bornity/deltesian-part-files/Deltesian - Gen 1/BOM/Deltesian - Gen1 BOM - Google Sheet Link.txt

Deltesian - Gen 1 BOM Google Sheet Link

NOTE: Work in Progress

https://goo.gl/rh56ii
