bornity/deltesian-part-files/Deltesian - Gen 2/Sub-Plate Plate V2.2 - Printed.stl

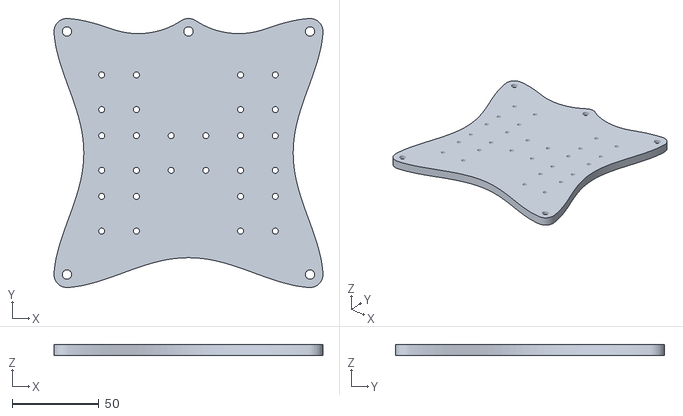
[picture p9: CAD file, 2018-10-27]
Deltesian - Gen 2/Sub-Plate Plate V2.2 - Printed.stl
155.0 x 155.0 x 6.50
