bornity/deltesian-part-files/Stage 1 - XZ Frame/v1.0.1 - XZ Frame/STL/Z_Axis Corner Bracket v1.0.stl

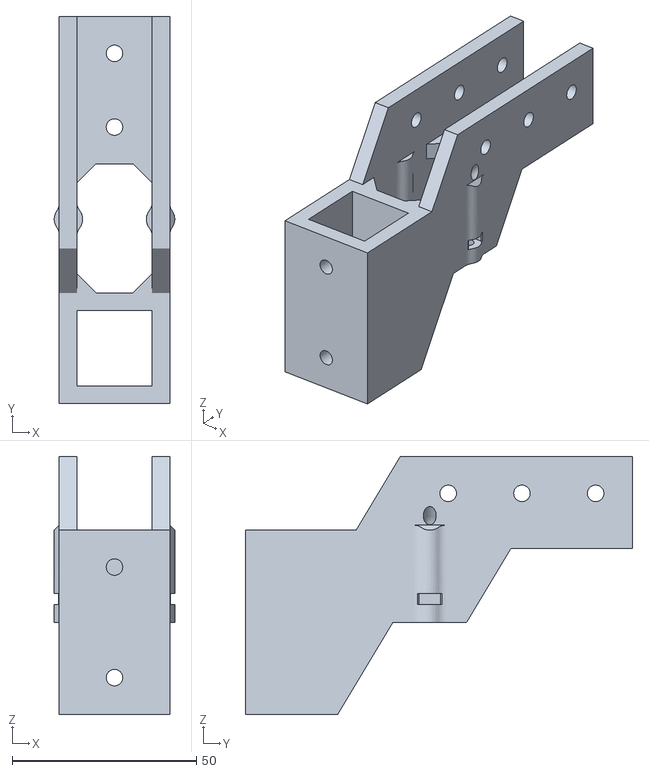
[picture p10: CAD file, 2018-03-16]
Stage 1 - XZ Frame/v1.0.1 - XZ Frame/STL/Z_Axis Corner Bracket v1.0.stl
32.7 x 105.0 x 70.0
