bornity/deltesian-part-files/Stage 2 - Y_Axis/V1.0.1 - Single Bed Y_Axis/STL/Y_Axis Carriage Plate Arm v1.0.stl

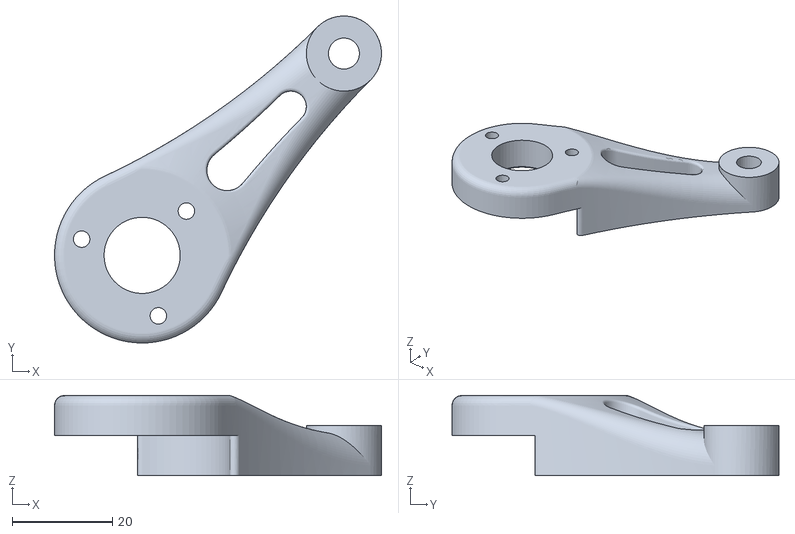
[picture p11: CAD file, 2018-03-14]
Stage 2 - Y_Axis/V1.0.1 - Single Bed Y_Axis/STL/Y_Axis Carriage Plate Arm v1.0.stl
65.3 x 65.3 x 16.0
