bornity/deltesian-part-files/Stage 3 - Effector and Arms/v1.0 - Effector and Arms/STL/Tower Carriage Bracket v1.0.stl

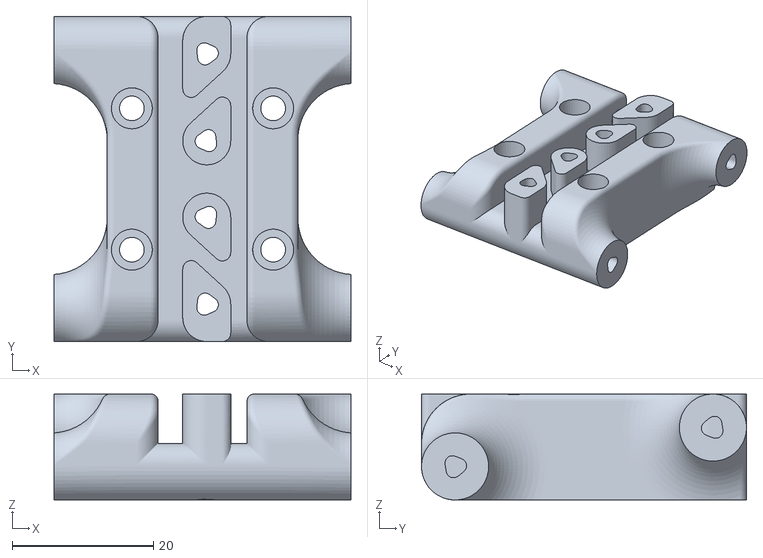
[picture p12: CAD file, 2018-03-16]
Stage 3 - Effector and Arms/v1.0 - Effector and Arms/STL/Tower Carriage Bracket v1.0.stl
42.0 x 46.0 x 15.0
