bornity/deltesian-part-files/Y-Axis Designs/Center Mount Stepper - Y_Axis/Y_Axis Double Rail - EXTR Flat Mount Bracket - Half - v1.0.stl

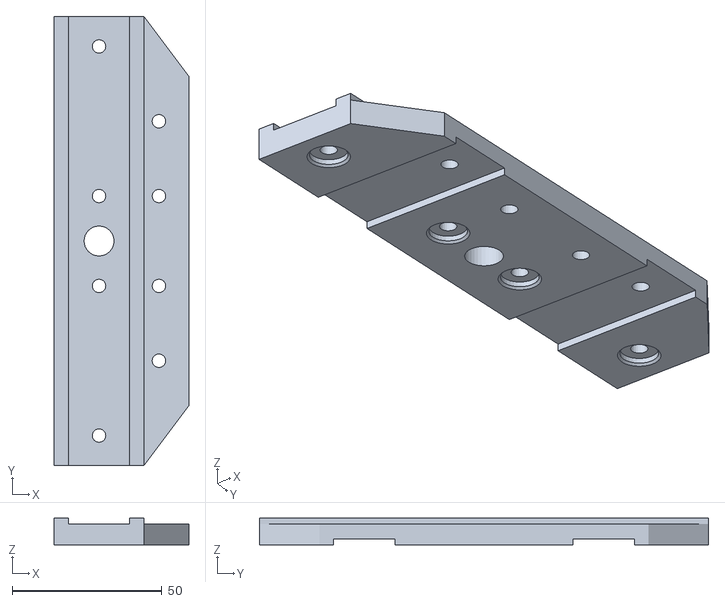
[picture p13: CAD file, 2019-02-25]
Y-Axis Designs/Center Mount Stepper - Y_Axis/Y_Axis Double Rail - EXTR Flat Mount Bracket - Half - v1.0.stl
45.0 x 150.0 x 9.00
