bornity/deltesian-part-files/Deltesian - Gen 2/GEN2 - Y_Axis  - DoubleRail_RearStepperBracket.stl

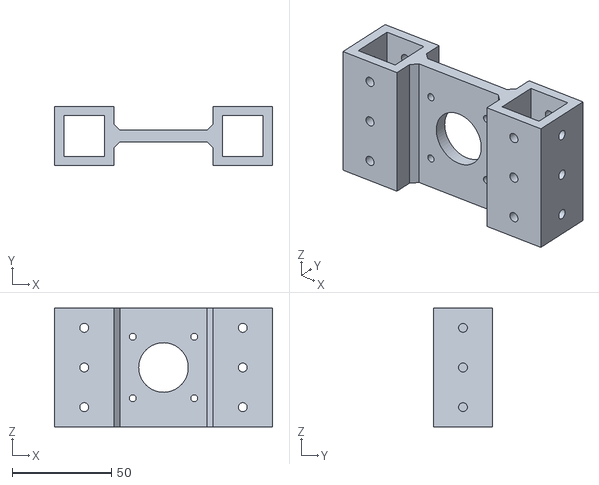
[picture p14: CAD file, 2018-07-15]
Deltesian - Gen 2/GEN2 - Y_Axis - DoubleRail_RearStepperBracket.stl
110.0 x 30.0 x 60.0
