bornity/deltesian-part-files/Stage 2 - Y_Axis/V1.0.1 - Single Bed Y_Axis/STL/Y_Axis Stepper Mount Bracket V1.0.stl

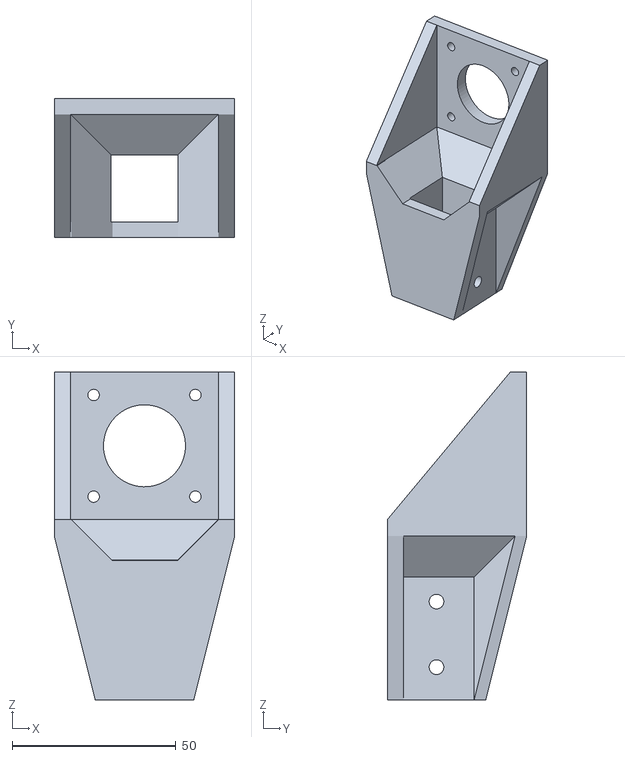
[picture p15: CAD file, 2018-03-14]
Stage 2 - Y_Axis/V1.0.1 - Single Bed Y_Axis/STL/Y_Axis Stepper Mount Bracket V1.0.stl
55.0 x 42.5 x 100.0
