bornity/deltesian-part-files/Y-Axis Designs/Center Mount Stepper - Y_Axis/Y_Axis Double Rail - EXTR Flat Mount Bracket - v1.0.stl

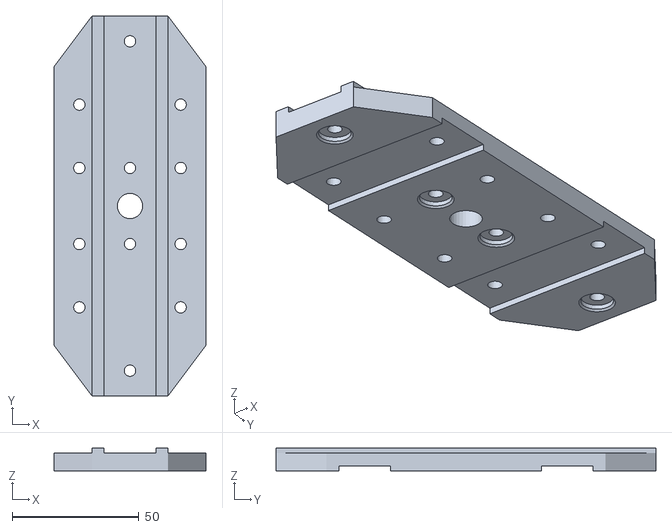
[picture p16: CAD file, 2019-02-25]
Y-Axis Designs/Center Mount Stepper - Y_Axis/Y_Axis Double Rail - EXTR Flat Mount Bracket - v1.0.stl
60.0 x 150.0 x 9.00
