bornity/deltesian-part-files/Deltesian - Gen 2/GEN2 - Y_Axis - Multi_EXTR_Mount - v1.0.stl

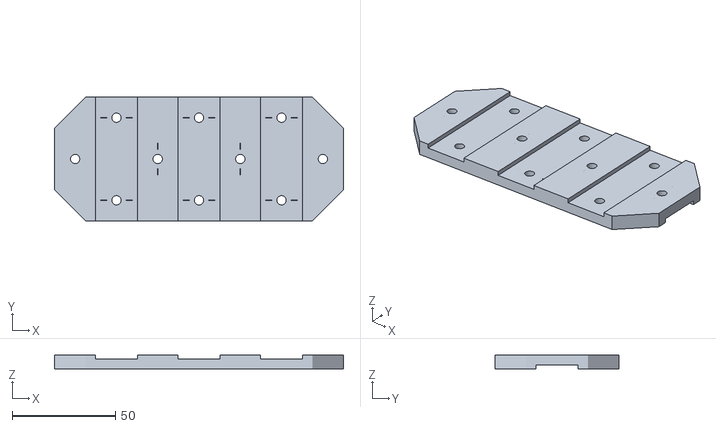
[picture p17: CAD file, 2018-07-15]
Deltesian - Gen 2/GEN2 - Y_Axis - Multi_EXTR_Mount - v1.0.stl
140.0 x 60.0 x 7.00
