bornity/deltesian-part-files/Y-Axis Designs/Center Mount Stepper - Y_Axis/Y_Axis Double Rail - Double 5mm Idler - V1.0.stl

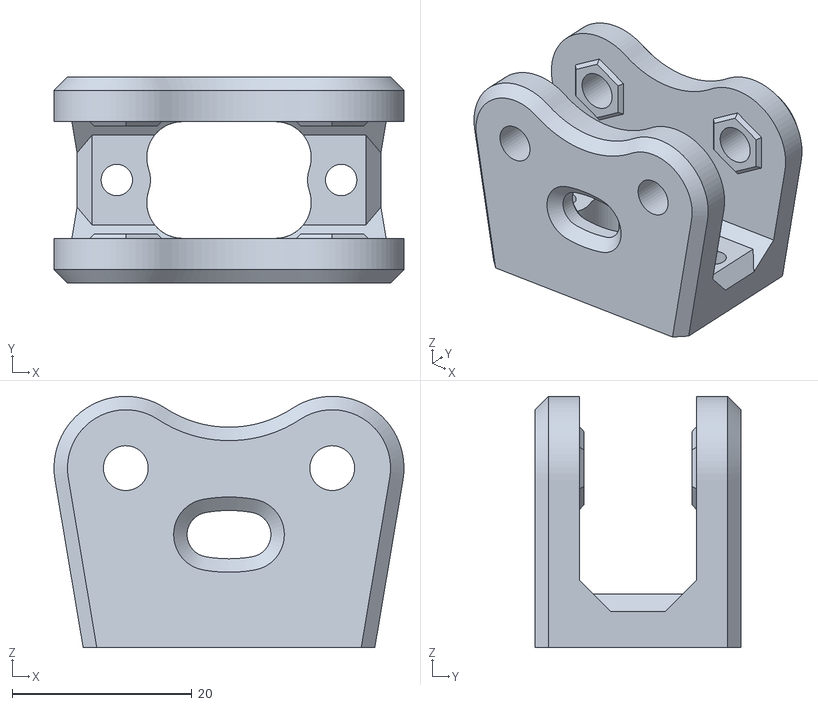
[picture p18: CAD file, 2019-02-24]
Y-Axis Designs/Center Mount Stepper - Y_Axis/Y_Axis Double Rail - Double 5mm Idler - V1.0.stl
39.0 x 23.0 x 28.0
