bornity/deltesian-part-files/Deltesian - Gen 2/GEN2 - Y_Axis  - DoubleRail_FrontBracket.stl

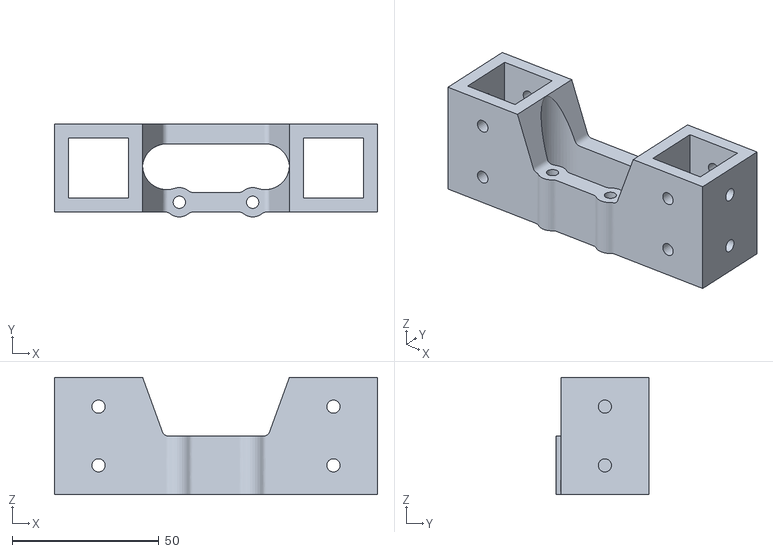
[picture p19: CAD file, 2018-07-15]
Deltesian - Gen 2/GEN2 - Y_Axis - DoubleRail_FrontBracket.stl
110.0 x 31.6 x 40.0
