bornity/deltesian-part-files/Deltesian - Gen 2/GEN2 - Z_Axis - Corner_Bracket V1.2.stl

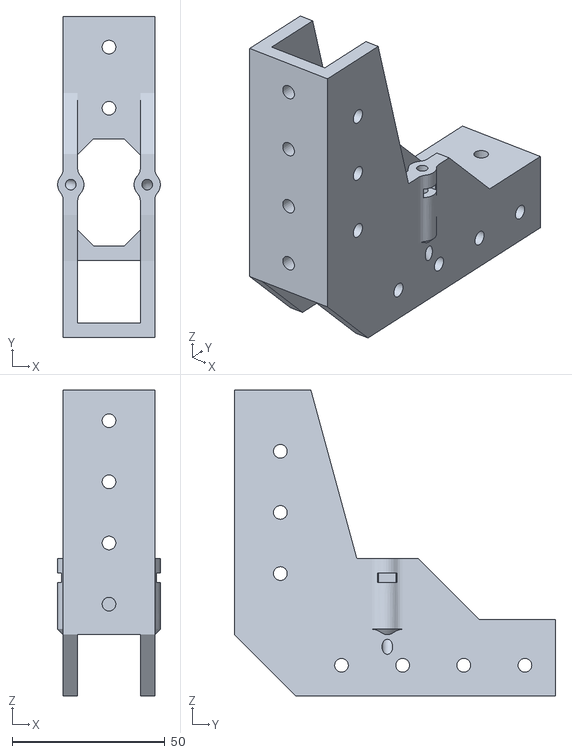
[picture p20: CAD file, 2018-07-12]
Deltesian - Gen 2/GEN2 - Z_Axis - Corner_Bracket V1.2.stl
33.6 x 105.0 x 100.0
