bornity/deltesian-part-files/Y-Axis Designs/Center Mount Stepper - Y_Axis/Y_Axis Double Rail - Carriage Plate Belt Retainer Bracket.stl

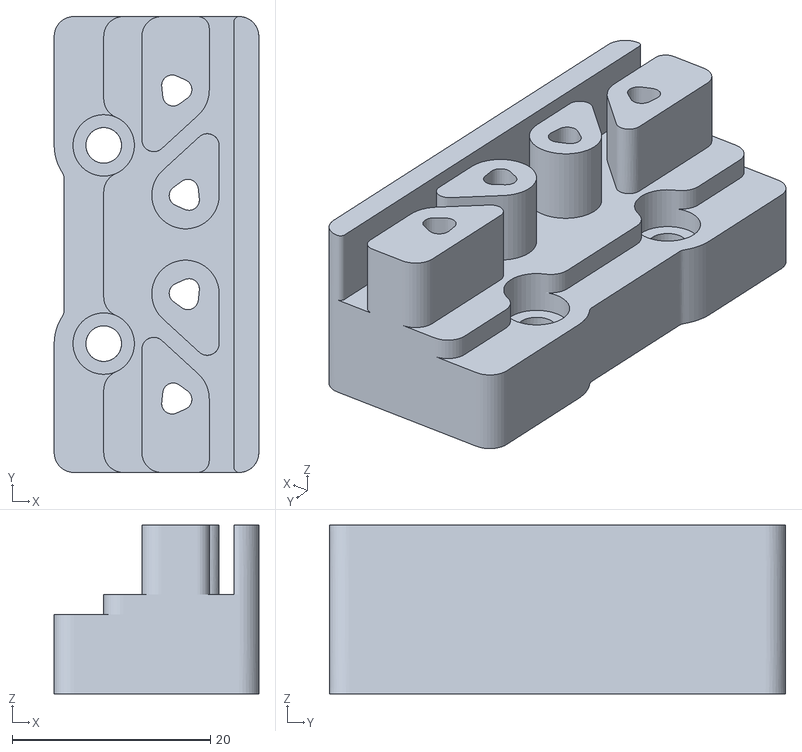
[picture p21: CAD file, 2019-02-24]
Y-Axis Designs/Center Mount Stepper - Y_Axis/Y_Axis Double Rail - Carriage Plate Belt Retainer Bracket.stl
20.6 x 46.0 x 17.0
