bornity/deltesian-part-files/Y-Axis Designs/Center Mount Stepper - Y_Axis/Y_Axis Double Rail - Double 3mm Idler - V1.0.stl

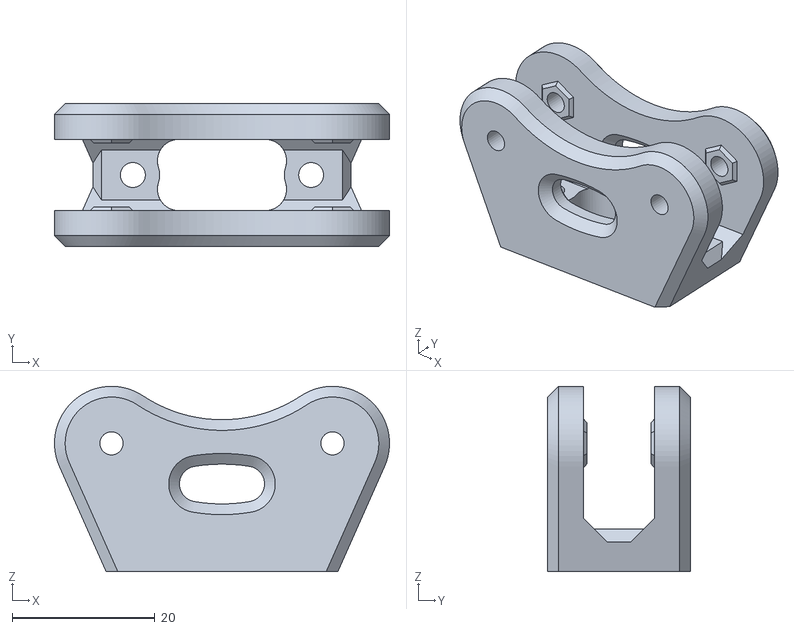
[picture p22: CAD file, 2019-02-24]
Y-Axis Designs/Center Mount Stepper - Y_Axis/Y_Axis Double Rail - Double 3mm Idler - V1.0.stl
47.0 x 20.0 x 26.0
