bornity/deltesian-part-files/Y-Axis Designs/Center Mount Stepper - Y_Axis/Y_Axis Double Rail - Tension & Spacer Bar.stl

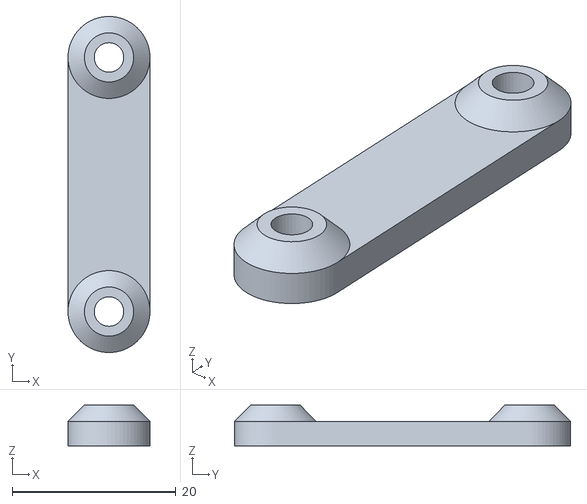
[picture p23: CAD file, 2019-02-21]
Y-Axis Designs/Center Mount Stepper - Y_Axis/Y_Axis Double Rail - Tension & Spacer Bar.stl
10.0 x 41.0 x 5.00
