bornity/deltesian-part-files/Y-Axis Designs/Center Mount Stepper - Y_Axis/Y_Axis Double Rail - End Bracket.stl

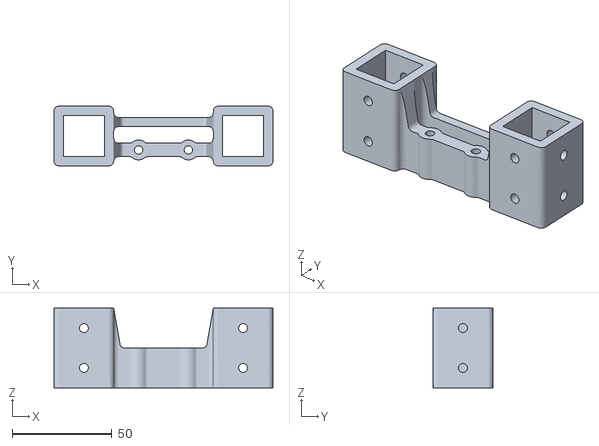
[picture p24: CAD file, 2019-02-21]
Y-Axis Designs/Center Mount Stepper - Y_Axis/Y_Axis Double Rail - End Bracket.stl
110.0 x 30.0 x 40.0
