bornity/deltesian-part-files/Y-Axis Designs/Center Mount Stepper - Y_Axis/Printed Sub-Leveling Frame V2.2 - 3pt & 4pt Leveling.stl

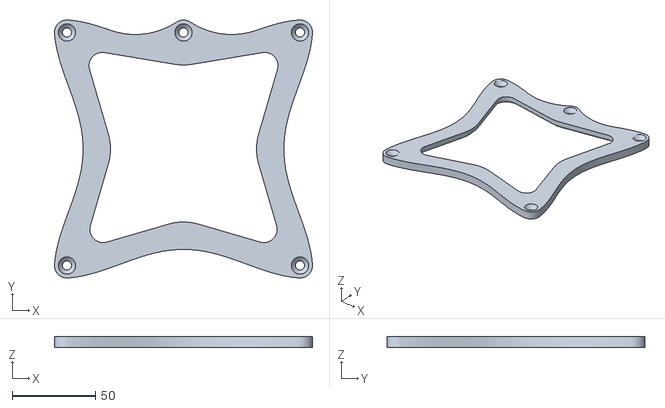
[picture p25: CAD file, 2019-02-21]
Y-Axis Designs/Center Mount Stepper - Y_Axis/Printed Sub-Leveling Frame V2.2 - 3pt & 4pt Leveling.stl
155.0 x 155.0 x 6.50
