bornity/deltesian-part-files/Y-Axis Designs/Center Mount Stepper - Y_Axis/Y_Axis Double Rail - Center Mount Stepper Bracket.stl

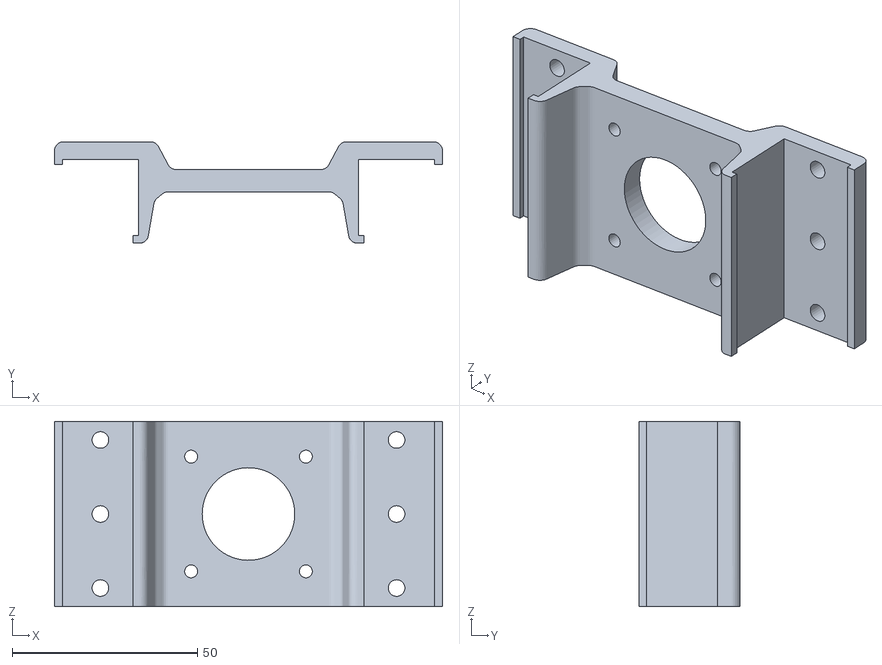
[picture p26: CAD file, 2019-02-21]
Y-Axis Designs/Center Mount Stepper - Y_Axis/Y_Axis Double Rail - Center Mount Stepper Bracket.stl
104.8 x 27.4 x 50.0
