bornity/deltesian-part-files/(list of files, cad)

Other CAD files:
Y-Axis Designs/Center Mount Stepper - Y_Axis/Printed Sub-Plate V2.2 - 3pt & 4pt Leveling.stl
Deltesian - Gen 1/1) XZ Main Frame/Alternate Parts/5_16in - Ø30mm Footpad.stl
Deltesian - Gen 1/1) XZ Main Frame/Footpad Boxed Design.stl
Deltesian - Gen 1/1) XZ Main Frame/Footpad Thumbscrew for 5_16in Bolt.stl
Deltesian - Gen 1/1) XZ Main Frame/Footpad for 5_16in Hex Bolt.stl
Deltesian - Gen 1/1) XZ Main Frame/M4_20-60mm_HexT-Nut_10mm_2020_EXTR.stl
Deltesian - Gen 1/1) XZ Main Frame/Pulley Tensioner v1.0.stl
Deltesian - Gen 1/1) XZ Main Frame/Small Build Volume Parts/XYZ Main Corner Bracket - sbv1.0.stl
Deltesian - Gen 1/1) XZ Main Frame/XYZ Main Corner Bracket v1.0.stl
Deltesian - Gen 1/1) XZ Main Frame/Z_Axis Corner Bracket v1.1.stl
Deltesian - Gen 1/1) XZ Main Frame/_Old Versions/Z_Axis Corner Bracket v1.1.stl
Deltesian - Gen 1/2) Y Bed Assembly/Leveling Frame Connector V1.0.stl
Deltesian - Gen 1/2) Y Bed Assembly/Leveling Frame Corner V1.0.stl
Deltesian - Gen 1/2) Y Bed Assembly/M3_25mm-Centers-T-Nut.stl
Deltesian - Gen 1/2) Y Bed Assembly/Optional Parts/Y_Axis Stepper Mount Bracket- Safety Cover.stl
Deltesian - Gen 1/2) Y Bed Assembly/Pulley Tensioner V1.0.stl
Deltesian - Gen 1/2) Y Bed Assembly/Small Build Volume Parts/Y_Axis EXTR Flat Mount Bracket - sbv1.0.stl
Deltesian - Gen 1/2) Y Bed Assembly/Thumbscrews - 10-32 x 3_4in Dia x 4mm THK.stl
Deltesian - Gen 1/2) Y Bed Assembly/Y_Axis Carriage Plate Arm v1.0.1.stl
Deltesian - Gen 1/2) Y Bed Assembly/Y_Axis Carriage Plate Hub v1.0.stl
Deltesian - Gen 1/2) Y Bed Assembly/Y_Axis EXTR Flat Mount Bracket V1.0.stl
Deltesian - Gen 1/2) Y Bed Assembly/Y_Axis Pulley Mount Bracket V1.0.1.stl
Deltesian - Gen 1/2) Y Bed Assembly/Y_Axis Pulley Mount Bracket V1.0.stl
Deltesian - Gen 1/2) Y Bed Assembly/Y_Axis Stepper Mount Bracket V1.0.2.stl
Deltesian - Gen 1/3) Effector and Arms/Assembled - Effector and Arms v1.0.igs
Deltesian - Gen 1/3) Effector and Arms/Ball Bearing Arm 217mm v1.0.stl
Deltesian - Gen 1/3) Effector and Arms/Ball Bearing Arm 217mm v2.0.stl
Deltesian - Gen 1/3) Effector and Arms/Deltesian Effector 36_5-5 v1.0.stl
Deltesian - Gen 1/3) Effector and Arms/M3 Spacer Washers - X24.stl
Deltesian - Gen 1/3) Effector and Arms/Rod Arm Crossbrace v1.0.1.stl
Deltesian - Gen 1/3) Effector and Arms/Small Build Volume Parts/Ball Bearing Arm 217mm sbv1.0.1 - Print Orientation.stl
Deltesian - Gen 1/3) Effector and Arms/Small Build Volume Parts/Ball Bearing Arm 217mm sbv1.0.1-CenterSpar.stl
Deltesian - Gen 1/3) Effector and Arms/Small Build Volume Parts/Ball Bearing Arm 217mm sbv1.0.1-End_1.stl
Deltesian - Gen 1/3) Effector and Arms/Small Build Volume Parts/Ball Bearing Arm 217mm sbv1.0.1-End_2.stl
Deltesian - Gen 1/3) Effector and Arms/Small Build Volume Parts/Ball Bearing Arm 247mm sbv1.0.1-CenterSpar.stl
Deltesian - Gen 1/3) Effector and Arms/Small Build Volume Parts/Ball Bearing Arm 277mm sbv1.0.1-CenterSpar.stl
Deltesian - Gen 1/3) Effector and Arms/Small Build Volume Parts/Old Versions/Ball Bearing Arm 217 sbv1.0_1of3.stl
Deltesian - Gen 1/3) Effector and Arms/Small Build Volume Parts/Old Versions/Ball Bearing Arm 217 sbv1.0_2of3.stl
Deltesian - Gen 1/3) Effector and Arms/Small Build Volume Parts/Old Versions/Ball Bearing Arm 217 sbv1.0_3of3.stl
Deltesian - Gen 1/3) Effector and Arms/Small Build Volume Parts/Old Versions/Ball Bearing Arm 217mm sbv1.0 - Print Layout.stl
Deltesian - Gen 1/4) Hotend Assemblies/5015 Blower Nozzles/5015 Blower Cooling Chute - FanFlare.stl
Deltesian - Gen 1/4) Hotend Assemblies/5015 Blower Nozzles/5015 Blower Cooling Chute - Long.stl
Deltesian - Gen 1/4) Hotend Assemblies/5015 Blower Nozzles/5015 Blower Cooling Chute - Medium V1.1.stl
Deltesian - Gen 1/4) Hotend Assemblies/5015 Blower Nozzles/5015 Blower Cooling Chute - Medium V1.2.stl
Deltesian - Gen 1/4) Hotend Assemblies/5015 Blower Nozzles/5015 Blower Cooling Chute - Medium V1.A.stl
Deltesian - Gen 1/4) Hotend Assemblies/5015 Blower Nozzles/5015 Blower Cooling Chute - Medium.stl
Deltesian - Gen 1/4) Hotend Assemblies/5015 Blower Nozzles/5015 Blower Cooling Chute.stl
Deltesian - Gen 1/4) Hotend Assemblies/v1.0 Generic E3D V5 Hotend Assembly - 40mm Fan/40mm Fan Mount Bracket V1.0.stl
Deltesian - Gen 1/4) Hotend Assemblies/v1.0 Generic E3D V5 Hotend Assembly - 40mm Fan/5015 Blower Mount Bracket V1.0.stl
Deltesian - Gen 1/4) Hotend Assemblies/v1.0 Generic E3D V5 Hotend Assembly - 40mm Fan/Deltesian Effector Solid 36_5-5 V1_2.stl
Deltesian - Gen 1/4) Hotend Assemblies/v1.0 Generic E3D V5 Hotend Assembly - 40mm Fan/Heatsink Extender Adapter V1.0.stl
Deltesian - Gen 1/4) Hotend Assemblies/v1.0 Generic E3D V5 Hotend Assembly - 40mm Fan/Heatsink Mount Bracket Retaining Clip V1.0.stl
Deltesian - Gen 1/4) Hotend Assemblies/v1.0 Generic E3D V5 Hotend Assembly - 40mm Fan/Heatsink Mount Bracket V1.0.stl
Deltesian - Gen 1/4) Hotend Assemblies/v1.0 Generic E3D V5 Hotend Assembly - 40mm Fan/_v1.0 Generic E3D Hotend Assembly - NOT PRINTABLE.igs
Deltesian - Gen 1/4) Hotend Assemblies/v1.0 Generic E3D V6 Hotend Assembly - 30mm Fan/5015 Blower Mount Bracket V1.0.stl
Deltesian - Gen 1/4) Hotend Assemblies/v1.0 Generic E3D V6 Hotend Assembly - 30mm Fan/Deltesian Effector Solid 36_5-5 V1_2.stl
Deltesian - Gen 1/4) Hotend Assemblies/v1.0 Generic E3D V6 Hotend Assembly - 30mm Fan/E3D V6 - Heatsink Mount Bracket V1.0.stl
Deltesian - Gen 1/4) Hotend Assemblies/v1.0 Generic E3D V6 Hotend Assembly - 30mm Fan/E3D V6 - Heatsink Retaining Clip V1.0.stl
Deltesian - Gen 1/4) Hotend Assemblies/v1.0 Generic E3D V6 Hotend Assembly - 30mm Fan/Heatsink Extender Adapter V1.0.stl
Deltesian - Gen 1/_MISC & Prototype Parts/2020 - 3 Hole Plate - M3 Nut Recesses.stl
Deltesian - Gen 1/_MISC & Prototype Parts/2020 Splicing Plate.stl
Deltesian - Gen 1/_MISC & Prototype Parts/Aussie Effector - Direct Drive - V1.1 - 17HS08-1004S.stl
Deltesian - Gen 1/_MISC & Prototype Parts/Aussie Effector Direct Drive - V1.1 - 17HS08-1004S VS Traditional Effector.idw
Deltesian - Gen 1/_MISC & Prototype Parts/Deltesian Effector 36_5-5 - GP.stl
Deltesian - Gen 1/_MISC & Prototype Parts/Electronics Mounting Bracket v1.2.stl
Deltesian - Gen 1/_MISC & Prototype Parts/Footpad Boxed Design v1.1.stl
Deltesian - Gen 1/_MISC & Prototype Parts/Footpad with Diagonal Brace Bracket v1.1.stl
Deltesian - Gen 1/_MISC & Prototype Parts/Pulley Tensioner V1.0 AL1.stl
Deltesian - Gen 1/_MISC & Prototype Parts/Rod Arm Crossbrace - 2pt Split Mount v1.1.stl
Deltesian - Gen 1/_MISC & Prototype Parts/Rod Arm Crossbrace - 6pt Mount (Lower Arms).stl
Deltesian - Gen 1/_MISC & Prototype Parts/Rod Arm Crossbrace - 7pt Mount v1.1.stl
Deltesian - Gen 1/_MISC & Prototype Parts/Triangle XZ Frame Stiffener Bracket v1.0.stl
Deltesian - Gen 1/_MISC & Prototype Parts/XYZ_Axis Seconary Pully Mount Bracket ALT4.stl
Deltesian - Gen 1/_MISC & Prototype Parts/XZ Frame Diagonal Brace v1.0.stl
Deltesian - Gen 1/_MISC & Prototype Parts/XZ Frame Diagonal Brace v1.0_Mirrored.stl
Deltesian - Gen 1/_MISC & Prototype Parts/Y_Axis EXTR Flat Mount Bracket Small - v1.0.stl
Deltesian - Gen 1/_MISC & Prototype Parts/Y_Axis Seconary Pully Mount Bracket ALT2.stl
Y-Axis Designs/Center Mount Stepper - Y_Axis/Knurled Knob - Captured Hex Nut - M3x18mmODx10mmTHK.stl
