bornity/deltesian-part-files/Deltesian - Gen 1/2) Y Bed Assembly/Build Guide - Y Bed Assembly.pdf

# BOM - Y_Axis - Single Bed - v1.0.1

QTY; PART NUMBER; 20-2020-BLACK-FB 450mm; MGN12 - Carriage; MGN12 300mm Linear Rail; Nema 17 Stepper - 50Ncm min; 3mm ID Idler Pulley - 6mm GT2 Belt; 1m GT2 6mm wide Timing Belt; GT2_20Tooth-Pulley; ISO 4762 - M3 x 20; ISO 4762 - M3 x 10; ISO 4032 - M3 Hex Nut; M4x10 Bolt & Square Nut-SET; Pulley Tensioner; Y_Axis Pulley Mount Bracket; Y_Axis Stepper Mount Bracket; Y_Axis EXTR Flat Mount Bracket - v1.0; 10-32 x 3_4in Dia x 4mm THK - Knurled Knob; M3_25mm-Center-T-Nuts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

Y_Axis Single Bed V1.0.1 BOM

Y_Axis Stepper Mount Bracket

Nema 17 Stepper x 50Ncm MIN

3mm ID Idler Pulley - GT2 6mm Belt

Y_Axis Pulley Mount Bracket

Y_Axis EXTR Flat Mount Bracket - v1.0

# BOM - Y_Axis - Single Bed - v1.0.1

QTY; PART NUMBER; 20-2020-BLACK-FB 450mm; MGN12 - Carriage; MGN12 300mm Linear Rail; Nema 17 Stepper - 50Ncm min; 3mm ID Idler Pulley - 6mm GT2 Belt; 1m GT2 6mm wide Timing Belt; GT2_20Tooth-Pulley; ISO 4762 - M3 x 20; ISO 4762 - M3 x 10; ISO 4032 - M3 Hex Nut; M4x10 Bolt & Square Nut-SET; Pulley Tensioner; Y_Axis Pulley Mount Bracket; Y_Axis Stepper Mount Bracket; Y_Axis EXTR Flat Mount Bracket - v1.0; 10-32 x 3_4in Dia x 4mm THK - Knurled Knob; M3_25mm-Center-T-Nuts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

Y_Axis Single Bed V1.0.1 BOM

# Y_Axis Carriage Plate Assembly v1.0.1

PARTS LIST; QTY; PART NUMBER; DESCRIPTION; ISO 4762 - M3 x 16; Hexagon Socket Head Cap Screw; ISO 4762 - M3 x 12; Y_Axis Carriage Plate Hub v1.0; Y_Axis Carriage Plate Arm v1.0.1

ISO 4762 - M3 x 12
(to Linear Rail Carriage)

Y_Axis Carriage Plate Arm v1.0.1

Y_Axis Carriage Plate Hub v1.0

# Y_Axis Multipart Leveling Plate - Schematic

PARTS LIST; QTY; PART NUMBER; DESCRIPTION; ANSI B18.6.3 - 10-32 x 2; Spline Socket Button Head Cap Screw; ISO 4762 - M3 x 8; Hexagon Socket Head Cap Screw; ISO 4032 - M3; Hexagon nuts, style 1 - Product grades A and B; Leveling Frame Corner V1.0; Leveling Frame Connector V1.0; ANSI B18.2.2 - 10 - 32; Hex Machine Screw Nut

Leveling Frame Corner V1.0

Leveling Frame Connector V1.0

## 10mm Cork Hotbed Insulation Sheet - Dimensions

UNITS: MM SCALE 1:2

NOTE:
CORK CAN BE SUBSTITUTED FOR
(4) Layers of Corrugated Cardboard
(minimum combined thickness 10mm)

# Deltesian - Y_Axis - Single Bed - v1.0.1 - EXPLODED VIEW


# Deltesian - Y_Axis - Single Bed - v1.0.1 - EXPLODED VIEW


# Deltesian - Y_Axis - Single Bed - v1.0.1 - EXPLODED VIEW


# Carriage Plate Arms Update v1.0 -> v1.0.1

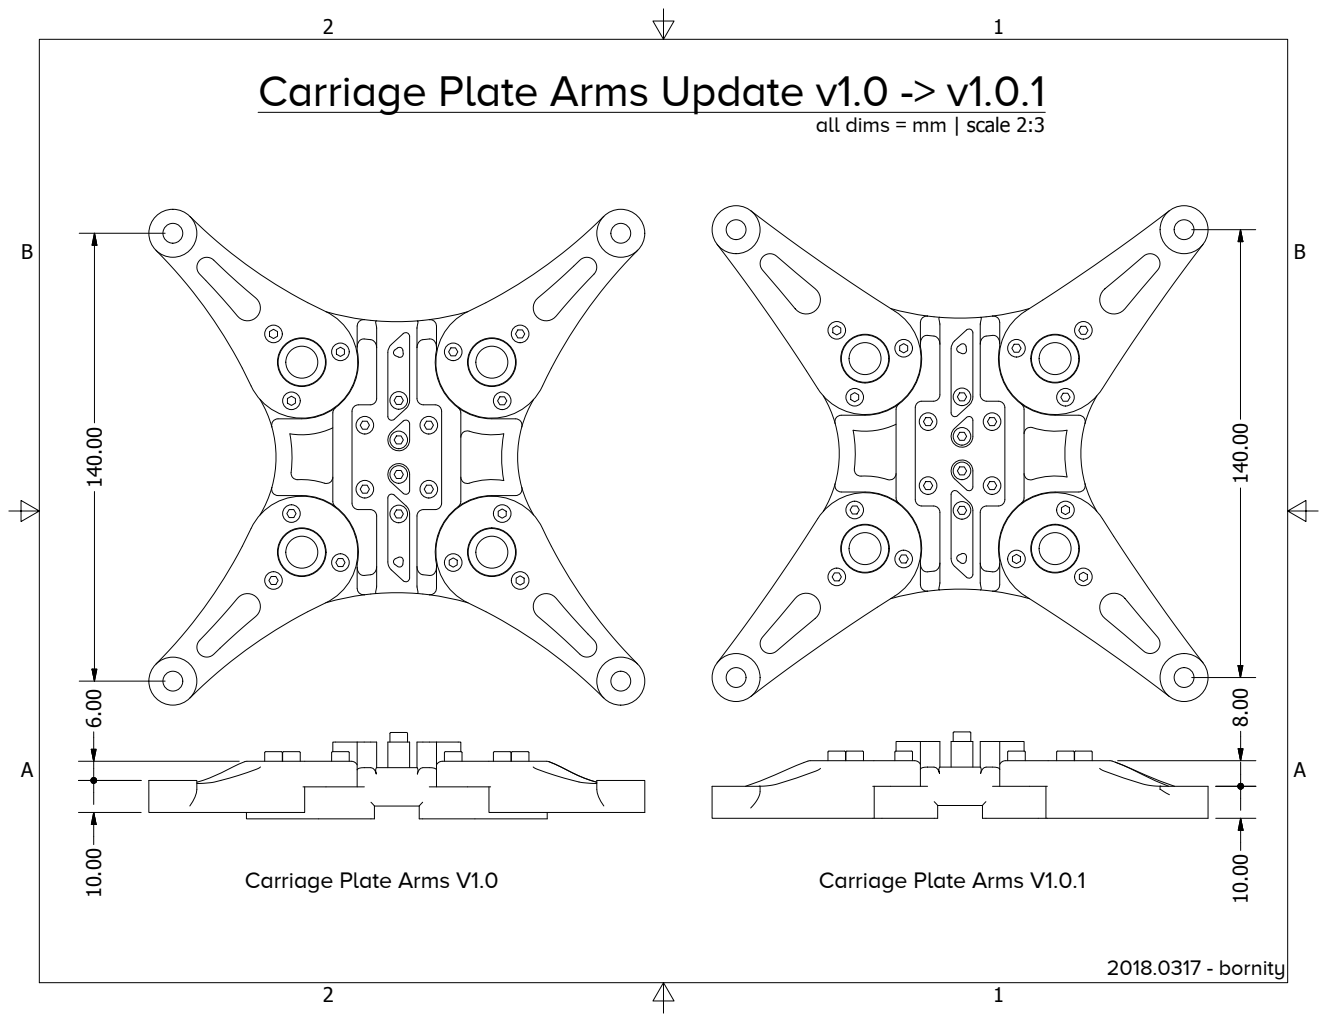
[picture p27: page 9]
Carriage Plate Arms V1.0; Carriage Plate Arms V1.0.1; 2018.0317 - bornity

all dims = mm | scale 2:3

## 10mm Cork Hotbed Insulation Sheet - Dimensions

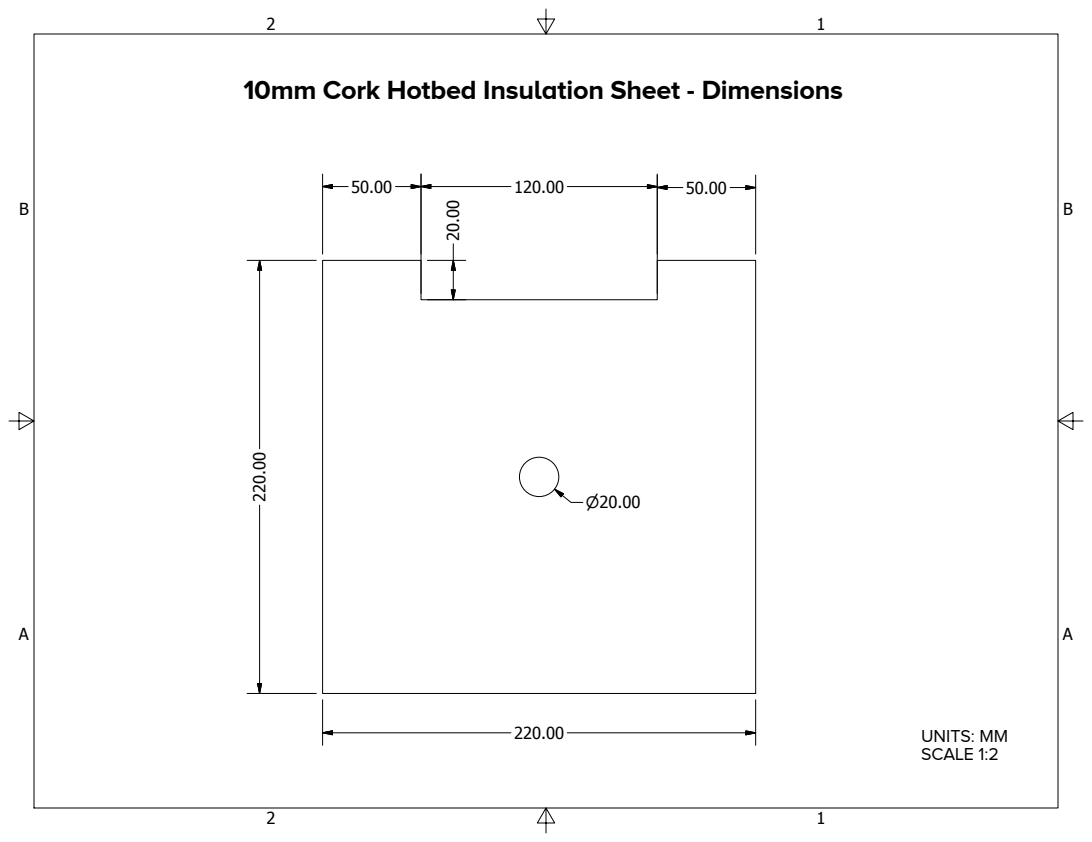
[picture p28: page 10]
UNITS: MM SCALE 1:2

## M3_25mm-Centers-T-Nuts - Linear Rails Attachment Option

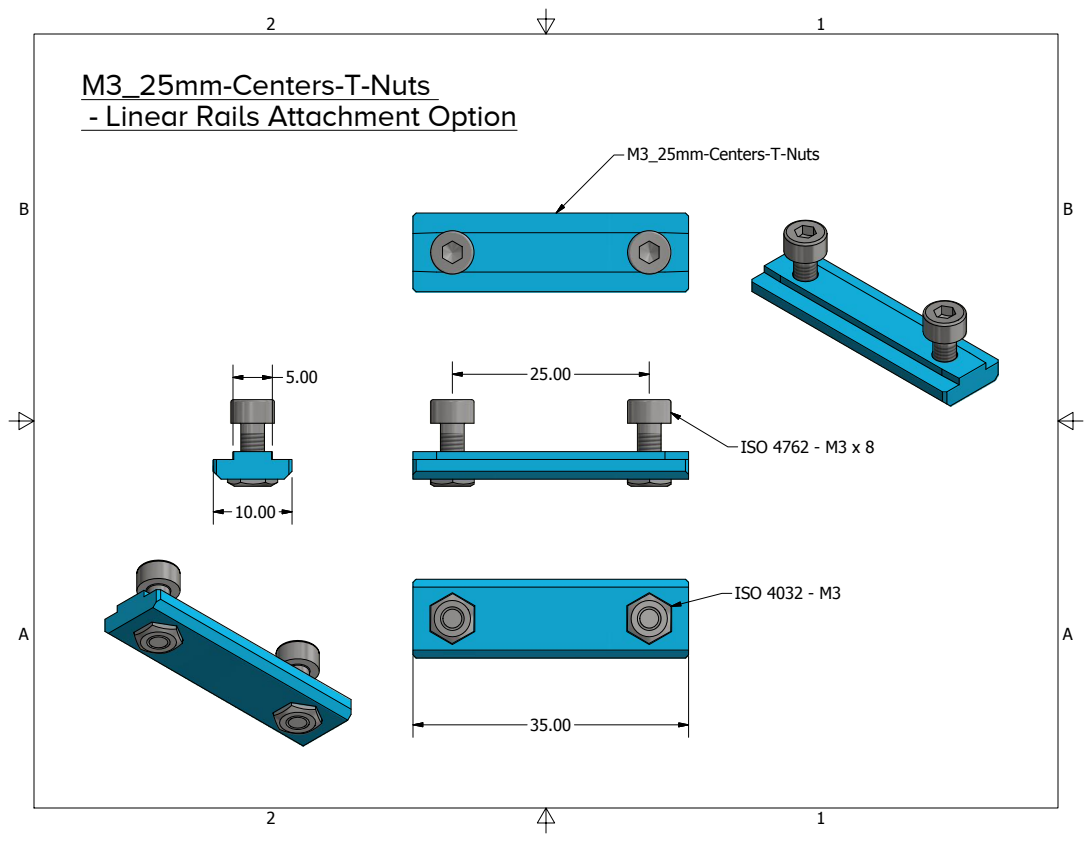
[picture p29: page 11]
ISO 4032 - M3; ISO 4762 - M3 x 8; M3_25mm-Centers-T-Nuts
