bornity/deltesian-part-files/(threads)

Thread 1 (2018-03-22):

Y_Axis Model Missing Parts

bornity, 2018-03-22:
Missing:
10-32 Leveling Screw Nuts
Buildplate
PCB Hotbed
Cork Sheet
VHB

bornity, 2018-04-07:
Added to Model.

Closed 2018-04-07.

Thread 3 (2018-03-23):

XZ Frame Missing Parts

bornity, 2018-03-23:
Timing Belts

bornity, 2018-04-07:
Added

Closed 2018-04-07.

Thread 4 (2018-04-07):

Leveling Frame Corner with longer arms

Leapo, 2018-04-07:
Feature request: Leveling Frame Corner with longer outer-arms to allow hard-mounting of 220mmx220mm heated beds.
