bornity/deltesian-part-files/Stage 2 - Y_Axis/V1.0.1 - Single Bed Y_Axis/Technical Drawings/Y_Axis Carriage Plate Assembly v1.0.1.pdf

# Carriage Plate Arms Update v1.0 -> v1.0.1

Carriage Plate Arms V1.0; Carriage Plate Arms V1.0.1; 2018.0317 - bornity

all dims = mm | scale 2:3
