bornity/deltesian-part-files/Stage 2 - Y_Axis/V1.0.1 - Single Bed Y_Axis/Technical Drawings/10mm Cork Hotbed Insulation Sheet.pdf

UNITS: MM SCALE 1:2

10mm Cork Hotbed Insulation Sheet - Dimensions
