bornity/deltesian-part-files/Stage 2 - Y_Axis/V1.0.1 - Single Bed Y_Axis/Technical Drawings/M3_25mm-Center-T-Nuts.pdf

# M3_25mm-Centers-T-Nuts - Linear Rails Attachment Option

ISO 4032 - M3; ISO 4762 - M3 x 8; M3_25mm-Centers-T-Nuts
