bornity/deltesian-part-files/Deltesian - Gen 1/3) Effector and Arms/Technical Drawings/217mm Dual Ball Bearing Arm - v1.0 vs v2.0.pdf

# 217mm Dual Ball Bearing Arm - v1.0 vs V2.0

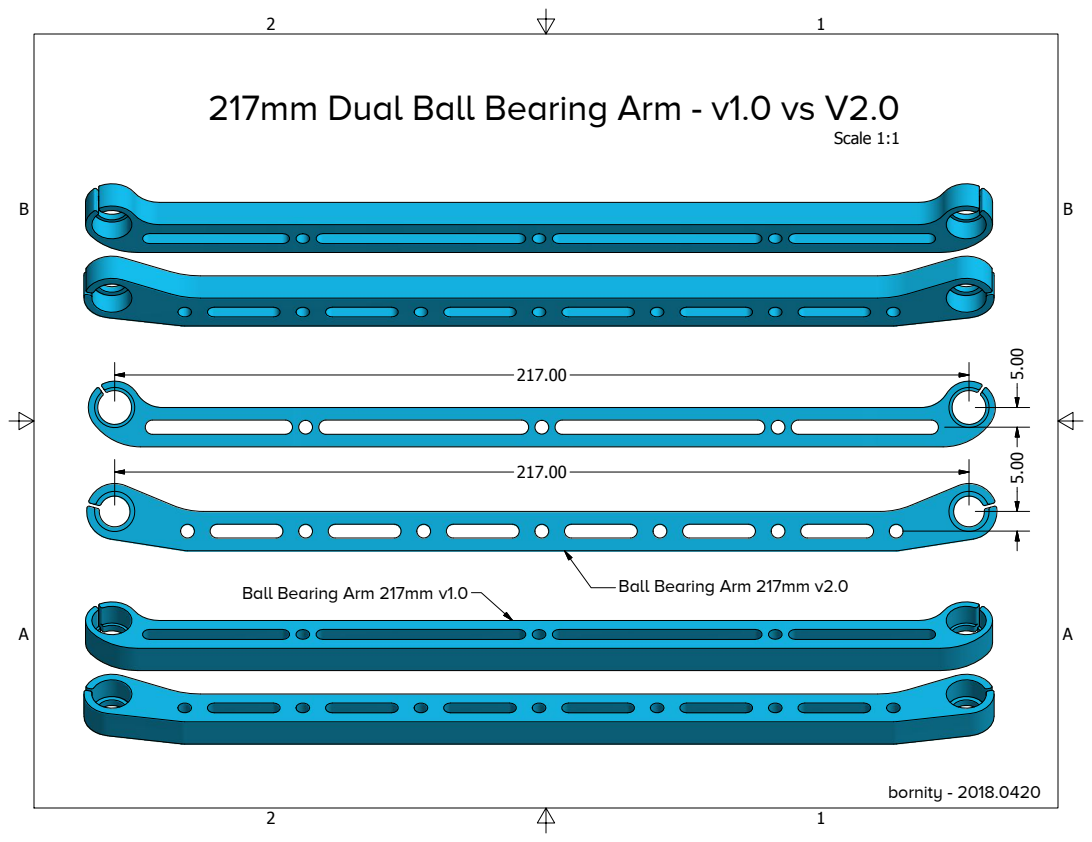
[picture p35: page 1]
Scale 1:1; bornity - 2018.0420

Ball Bearing Arm 217mm v2.0 Ball Bearing Arm 217mm v1.0
