bornity/deltesian-part-files/Deltesian - Gen 1/3) Effector and Arms/Technical Drawings/Ball Bearing Arm 217mm Update sbv1.0 - sbv1.0.1.pdf

# Multipart Ball Bearing Arm Update sbv1.0 -> sbv1.0.1

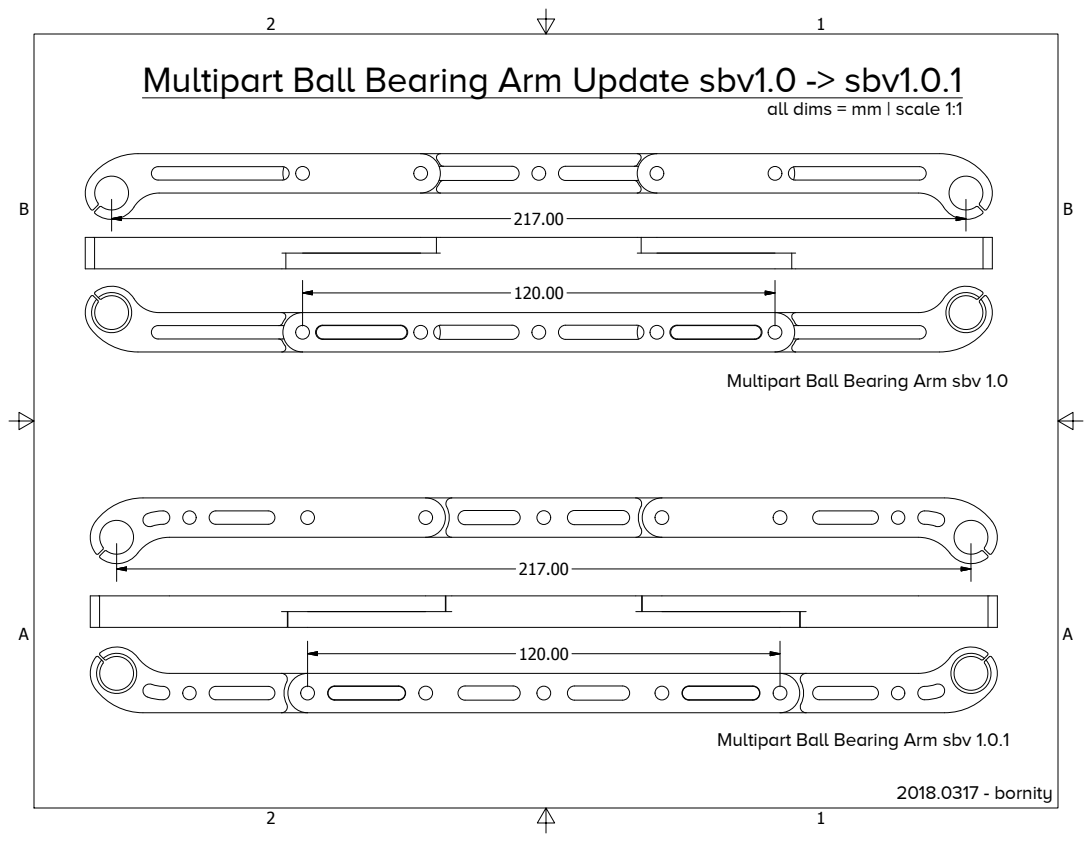
[picture p36: page 1]
2018.0317 - bornity

all dims = mm | scale 1:1

Multipart Ball Bearing Arm sbv 1.0

Multipart Ball Bearing Arm sbv 1.0.1
