bornity/deltesian-part-files/(commit log)

2018-03-14 Stage 1 - XZ Frame
2018-03-14 Stage 2 - Y_Axis
2018-03-14 Stage 3 - Effector & Arms
2018-03-14 Stage 0 - Plan Your Deltesian
2018-03-14 Stage 4 - Hotend
2018-03-14 Stage 5 - Electronics
2018-03-14 Stage 6 - Build Guides
2018-03-14 v1.0.1 Y_Axis Upload
2018-03-14 XZ Frame & Renderings
    V1.0.1 IGS files
2018-03-14 Y_Axis Single Bed STL File Uploads
    Initial STL Upload of STL Files
    Some part names changed for claritity
    [Leveling Frame Connector V1.0.stl, Leveling Frame Corner V1.0.stl, Pulley Tensioner V1.0.stl, Y_Axis Carriage Plate Arm v1.0.stl, Y_Axis Carriage Plate Hub v1.0.stl, Y_Axis EXTR Flat Mount Bracket V1.0.stl, Y_Axis Pulley Mount Bracket V1.0.stl, Y_Axis Stepper Mount Bracket V1.0.stl]
2018-03-14 Full Y_Axis Short Bed Assembly
    Fully Assebled STL of the Y_Axis Short Bed
2018-03-14 Added 10-32 Thumb Knobs
    Updated main STL
    [10-32 x 3_4in Dia x 4mm THK - Knurled Knob.stl]
2018-03-14 More Filename Cleanup
    Cleaning up directory for better readability
    [Thumbscrews - 10-32 x 3_4in Dia x 4mm THK.stl]
2018-03-14 XZ Frame + Single Bed
    Testing
2018-03-15 Adding More Part
    XZ Frame and Effector & Arms
2018-03-16 Adding Current STLs
    Adding STL's from Discord
    [Ball Bearing Arm 217mm v1.0.stl, Boxed Foot Design v1.0.stl, Deltesian Effector 36_5-5 v1.0.stl, Effector and Arms v1.0.igs, Footpad 5_16in v1.0.stl, Footpad Thumbscrew 5_16in v1.0.stl, Leveling Frame Connector V1.0.stl, Leveling Frame Corner V1.0.stl]
2018-03-17 Y_Axis Arm Update
    Stengthened Arms and Moved 2mm Lower
    [Y_Axis Carriage Plate Arm v1.0.1.stl, Y_Axis Carriage Plate Arm v1.0.stl]
2018-03-17 Updates to Parts
    Experimental Multipart Arms
    Fix for Carriage Plate Arms
    [Ball Bearing Arm 217mm sbv1.0.1 - Print Orientation.stl, Y_Axis Carriage Plate Arm v1.0.1.stl]
2018-03-17 Ball Bearing Arms sbv1.0.1 - Update Doc
    Technical Document of the Changes
2018-03-22 Y_Axis Technical Drawings and Parts
    Y_Axis Technical Drawings
    Alternate Foot Size
    [5_16in - Ø30mm Footpad.stl]
2018-03-22 Y_Axis Exploded View
    Pg 4 Exploded View
2018-03-23 Electronics Mounting Brackets
    Mounting Brackets
    [Mounting Bracket v1.2.stl]
2018-03-23 Adding Parts and Technical Documents
    M3_25mm-Center-T-Nut.stl
    New Y_Axis BOM/Build Guide document
    [M3_25mm-Centers-T-Nut.stl]
2018-03-23 Small Build Volume Arms sbv1.0 & sbv1.01
    Adding the Small Build Volume Arms
    [Ball Bearing Arm 217 sbv1.0_1of3.stl, Ball Bearing Arm 217 sbv1.0_2of3.stl, Ball Bearing Arm 217 sbv1.0_3of3.stl, Ball Bearing Arm 217mm sbv1.0.1 - Print Orientation.stl, Ball Bearing Arm 217mm sbv1.0.1-CenterSpar.stl, Ball Bearing Arm 217mm sbv1.0.1-End_1.stl, Ball Bearing Arm 217mm sbv1.0.1-End_2.stl]
2018-03-23 sbv Arms sbv1.0 - Print Layout Upload
    Print Layout stl
    [Ball Bearing Arm 217mm sbv1.0 - Print Layout.stl]
2018-03-23 Rest of SBV files & First Generic Hot End files
    Remaining SBV files: XYZ Main Bracket & Y_Axis flat mount bracket
    Hotend parts
    [40mm Fan Mount Bracket V1.0.stl, 5015 Blower Mount Bracket V1.0.stl, Deltesian Effector Solid 36_5-5 V1_2.stl, Heatsink Extender Adapter V1.0.stl, Heatsink Mount Bracket Retaining Clip V1.0.stl, Heatsink Mount Bracket V1.0.stl, XYZ Main Corner Bracket - sbv1.0.stl, Y_Axis EXTR Flat Mount Bracket - sbv1.0.stl]
2018-03-29 2020 Splicing Plate for 4mm Fasteners
    2020 Splicing Plate for 4mm Fasteners
    [2020 Splicing Plate.stl]
2018-03-29 IGS File of the Hotend Assembly
    IGS File of the Hotend Assembly
    [_v1.0 Generic E3D Hotend Assembly - NOT PRINTABLE.igs]
2018-03-31 E3D V5 & V6 Hotend Parts
    E3D V5 & V6 Hotend Parts
    [40mm Fan Mount Bracket V1.0.stl, 5015 Blower Mount Bracket V1.0.stl, Deltesian Effector Solid 36_5-5 V1_2.stl, E3D V6 - Heatsink Mount Bracket V1.0.stl, E3D V6 - Heatsink Retaining Clip V1.0.stl, Heatsink Extender Adapter V1.0.stl, Heatsink Mount Bracket Retaining Clip V1.0.stl, Heatsink Mount Bracket V1.0.stl]
2018-04-04 Renaming Footpad Parts for Better Clarity
    Renaming Footpad Parts for Better Clarity
    [Deltesian Effector 36_5-5 - GP.stl, Footpad Boxed Design.stl, Footpad Thumbscrew for 5_16in Bolt.stl, Footpad for 5_16in Hex Bolt.stl]
2018-04-04 Update Example Configuration with Heated Bed Modeled
    Update Example Configuration with Heated Bed Modeled
2018-04-05 Idler Pulley Sleeve for (2) 623 Bearings
    Idler Pulley Sleeve for (2) 623 Bearings
    [Idler Pulley Sleeve - 623 Bearing - Half Notched.stl]
2018-04-05 New Versions of Parts, Full IGS Model, Longer Arm Linkages
    New Versions of Parts, Full IGS Model, Longer Arm Linkages
    [Ball Bearing Arm 247mm sbv1.0.1-CenterSpar.stl, Ball Bearing Arm 277mm sbv1.0.1-CenterSpar.stl, Y_Axis Pulley Mount Bracket V1.0.1.stl, Y_Axis Stepper Mount Bracket V1.0.2.stl, Y_Axis Stepper Mount Bracket V1.0.stl]
2018-04-05 2020 - 3 Hole Plate - M3 Nut Recesses
    2020 - 3 Hole Plate - M3 Nut Recesses
    [2020 - 3 Hole Plate - M3 Nut Recesses.stl]
2018-04-05 Safety Cover for Y_Axis Stepper Motor
    Safety Cover for Y_Axis Stepper Motor
    [Y_Axis Stepper Mount Bracket- Safety Cover.stl]
2018-04-07 Updated Y_Axis Single Bed Build Guide
    Updated Y_Axis Single Bed Build Guide
2018-04-07 Naming Convention for the Y_Axis Build Guide
    Naming Convention for the Y_Axis Build Guide
2018-04-09 New Prototype Diagonal Brace Parts
    New Diagonal Brace Parts For Improving the Frames Front to Back Stiffness
    [Footpad with Diagonal Brace Bracket v1.1.stl, Triangle XZ Frame Stiffener Bracket v1.0.stl]
2018-04-09 New Prototype Crossbraces for Testing
    New Crossbrace Designs for Testing
    [Rod Arm Crossbrace - 2pt Split Mount v1.1.stl, Rod Arm Crossbrace - 7pt Mount v1.1.stl]
2018-04-09 Added Bracing Parts Folder
    Added Bracing Parts Folder, Moved parts to it
    [Footpad Boxed Design v1.1.stl, Footpad with Diagonal Brace Bracket v1.1.stl, Triangle XZ Frame Stiffener Bracket v1.0.stl]
2018-04-09 Updating Part Models
    Updating Part Models
    [Rod Arm Crossbrace - 2pt Split Mount v1.1.stl, Rod Arm Crossbrace - 7pt Mount v1.1.stl]
2018-04-14 New Tower Carriage Bracket Design
    New Tower Carriage Bracket Design
    Greatly reinforces the arms with extra material in the arms.
    [Tower Carriage Bracket v1.0.stl]
2018-04-17 5015 Blower Nozzles
    5015 Blower Nozzles
    [5015 Blower Cooling Chute - FanFlare.stl, 5015 Blower Cooling Chute - Long.stl, 5015 Blower Cooling Chute - Medium V1.1.stl, 5015 Blower Cooling Chute - Medium V1.2.stl, 5015 Blower Cooling Chute - Medium V1.A.stl, 5015 Blower Cooling Chute - Medium.stl, 5015 Blower Cooling Chute.stl]
2018-04-18 Diagonal Arm Braces for the XZ Frame
    Test Diagonal Arm Braces for the XZ Frame
    [XZ Frame Diagonal Brace v1.0.stl, XZ Frame Diagonal Brace v1.0_Mirrored.stl]
2018-04-19 Hole Reinforcement on the Diagonal Frame Braces
    [XZ Frame Diagonal Brace v1.0.stl, XZ Frame Diagonal Brace v1.0_Mirrored.stl]
2018-04-20 Updated Version of The Solid Ball Bearing Arm
    Increased Stiffness of the Knuckle and Arm Itself
    [Ball Bearing Arm 217mm v2.0.stl]
2018-04-21 Technical Drawings for Changes to Ball Bearing Arms from v1.0 vs v2.0
2018-05-01 Updated & Reoriented Corner Bracket
    Z_Axis Corner Bracket was incorrectly oriented for printing.
    Also added axuilary holes on the sides and extended the channel to reduce the amount of support required.
    [Z_Axis Corner Bracket v1.0.stl, Z_Axis Corner Bracket v1.1.stl]
2018-05-04 Added the Direct Drive Effector
    [Aussie Effector - Direct Drive - V1.1 - 17HS08-1004S.stl]
2018-05-15 Couple Additional Prototype Parts & Technical Drawings
    [Aussie Effector Direct Drive - V1.1 - 17HS08-1004S VS Traditional Effector.idw, Y_Axis EXTR Flat Mount Bracket Small - v1.0.stl]
2018-07-04 Cleaning up the Deltesian File Structure
    [2020 - 3 Hole Plate - M3 Nut Recesses.stl, 2020 Splicing Plate.stl, 40mm Fan Mount Bracket V1.0.stl, 5015 Blower Cooling Chute - FanFlare.stl, 5015 Blower Cooling Chute - Long.stl, 5015 Blower Cooling Chute - Medium V1.1.stl, 5015 Blower Cooling Chute - Medium V1.2.stl, 5015 Blower Cooling Chute - Medium V1.A.stl]
2018-07-04 Link to the Deltesian Gen1 BOM Google Sheet
2018-07-12 Stiffer Z_Axis Corner Bracket + Matching HexT-Nut Insert
    [M4_20-60mm_HexT-Nut_10mm_2020_EXTR.stl, Z_Axis Corner Bracket V1.2.stl, Z_Axis Corner Bracket v1.1.stl]
2018-07-15 GEN2 - Parts For Y-Axis & Stiffer Z-Corner Bracket
    [GEN2 - Y_Axis - DoubleRail_FrontBracket.stl, GEN2 - Y_Axis - DoubleRail_RearStepperBracket.stl, GEN2 - Y_Axis - Multi_EXTR_Mount - v1.0.stl, GEN2 - Z_Axis - Corner_Bracket V1.2.stl]
2018-10-27 3|4 Point Carriage Plate Prototype
    Prototype 4 or 3 Point Carriage Plate
    [Sub-Plate Plate V2.2 - Printed.stl]
2019-02-21 Y_Axis Design - Center Mounted Stepper
    New Y_Axis Design with Dual Linear Rails and a Center Mounted Stepper for reduced overall Length
    [Printed Sub-Leveling Frame V2.2 - 3pt & 4pt Leveling.stl, Printed Sub-Plate V2.2 - 3pt & 4pt Leveling.stl, Y_Axis Double Rail - Carriage Plate Belt Retainer Bracket.stl, Y_Axis Double Rail - Center Mount Stepper Bracket.stl, Y_Axis Double Rail - Double 3mm Idler - V1.0.stl, Y_Axis Double Rail - Double 5mm Idler - V1.0.stl, Y_Axis Double Rail - End Bracket.stl, Y_Axis Double Rail - Tension & Space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]
2019-02-24 Update Y-Axis Designs/Center Mount Stepper - Y_Axis/Y_Axis Double Rail - Double 3mm Idler - V1.0.stl
    - Fixed incorrect rotation on Hex Nut Recesses
    - Fixed overhang in See-Thru slot to be printable w/o supports
    [Y_Axis Double Rail - Double 3mm Idler - V1.0.stl]
2019-02-24 Update Y-Axis Designs/Center Mount Stepper - Y_Axis/Y_Axis Double Rail - Carriage Plate Belt Retainer Bracket.stl
    - Center Set of Screw Reinforcemnt Holes was unintentionally blocked by Geometry
    - Made Holes full pass-thru
    [Y_Axis Double Rail - Carriage Plate Belt Retainer Bracket.stl]
2019-02-24 Update Y-Axis Designs/Center Mount Stepper - Y_Axis/Knurled Knob - Captured Hex Nut - M3x18mmODx10mmTHK.stl
    Knurled Knob for Capturing (2) M3 Hex Nuts as a Tensioner Knob
    [Knurled Knob - Captured Hex Nut - M3x18mmODx10mmTHK.stl]
2019-02-24 Update Y-Axis Designs/Center Mount Stepper - Y_Axis/Knurled Knob - Captured Hex Nut - M3x18mmODx10mmTHK.stl
    - Added Chamfer to Center Hole
    [Knurled Knob - Captured Hex Nut - M3x18mmODx10mmTHK.stl]
2019-02-24 Update Y-Axis Designs/Center Mount Stepper - Y_Axis/Y_Axis Double Rail - Double 5mm Idler - V1.0.stl
    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
    [Y_Axis Double Rail - Double 5mm Idler - V1.0.stl]
2019-02-25 Mounting Brackets for the Y_Axis to a Transverse Frame
    [Y_Axis Double Rail - EXTR Flat Mount Bracket - Half - v1.0.stl, Y_Axis Double Rail - EXTR Flat Mount Bracket - v1.0.stl]
2019-02-26 Create FULL ASSEMBLY - Prototype Y_Axis Double Rail - Center Mount Stepper.stl
    WIP Full Assembly for the Y_Axis Double Rail - Center Mount Stepper
